lukehsiao/eyelink-latency/(commit log)

2020-01-16 refactor(example): add clock to top left and trigger to bottom right
    This now uses 4 textures. Before the trigger, we alternate between a
    white box in the top left, and a black screen. This is a "clock" of the
    frames. After the trigger, we do the same, but also draw a white box in
    the bottom left.
2020-01-17 refactor(display.cc): reduce latency with call to glFinish
    Calling glFinish at the end of repaint reduces e2e latency by about 1
    frame (~4ms).
2020-01-17 refactor(example): exit after triggering and drawing a few frames
2020-01-17 feat(example): add arduino communication over serial
    Host PC sends 'g' to the Arduino to signal it to switch LEDs, take a
    time diff, and send it back over serial.
2020-01-17 refactor(example): just send a single byte as arduino command
2020-01-17 refactor(example): split display into separate thread
    Rather than have everything in the same loop and thread, this splits off
    a separate thread for drawing to the display, with two atomic reference.
    First to a trigger boolean to know when to draw the white square, and
    second to a drawing delay to be able to report back the value to the
    main thread.
2020-01-17 wip: test swap_interval=0 with own limiting
    Just so we can see a frame clock in the swap_interval=0 setting.
2020-01-28 docs(README): add sequence diagram overview
    Sequence diagram is generated using PlantUML using the web-service:
    https://www.planttext.com/
    The markup for the UML diagram is:
    ```
    @startuml
    Host->ASG: Switch Eye Command
    note over ASG: toggle IR LED, t_start = now()
    Host->Host: poll EyeLink for new samples
    ASG->ASG: sample = photodiode level
    note over Host: new EyeLink Sample > DELTA
    Host->Display: draw white box
    note over ASG: sample > trigger level, t_end = now()
    ASG -> Host: t_end - t_start
    @enduml
    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
2020-01-28 docs: add circuit schematic for IR LEDs and photodiode
2020-01-28 docs(README): add arduino script for ASG
2020-01-28 docs: add mount SVG and picture of measurement setup
2020-10-13 docs: add sample oscope waveform
2020-11-03 docs(README): fix error in circuit
    The previous circuit diagram would not work if you didn't have an
    oscilloscope connected to Vout. This is because we leave DC current no
    path to ground. This fixes the circuit to match the intention: get a
    reading from the photodiode in photoconductive mode while also doing a
    little low-pass filtering.
2021-02-17 docs(README): further fix circuit diagram
    This latest circuit diagram takes into account Thorlab's recommended
    photoconductive-mode circuit for the FDS100, as provided in the FDS100
    datasheet. This is a more correct circuit.
    While the previous circuit functioned for this purpose, this one makes
    more sense, and should also work fine. However, note that I have no
    physically tested this one yet.
    Fixes: 1bcf4d3d101a3e35998228223ff702195a708467
